ShawnHymel/Matrix_Bow_Tie/Hardware/BOM/Matrix_Bow_Tie.xlsx

Reference | Qty | Value | Footprint | Field4 | Vendor ID | Link | Notes
C1 C5 | 2 | 0.1uF | Capacitors:0603 |  | 490-1532-1-ND | https://www.digikey.com/product-detail/en/murata-electronics-north-america/GRM188R71C104KA01D/490-1532-1-ND/587771
C2 | 1 | 0.01uF | Capacitors:0603 |  | 490-1512-1-ND | https://www.digikey.com/product-detail/en/murata-electronics-north-america/GRM188R71H103KA01D/490-1512-1-ND/587862
C3 | 1 | 10uF | Capacitors:0805 |  | 490-3886-1-ND | https://www.digikey.com/product-detail/en/murata-electronics-north-america/GRM21BR61C106KE15L/490-3886-1-ND/965928
C4 | 1 | 100pF | Capacitors:0603 |  | 490-1427-1-ND | https://www.digikey.com/product-detail/en/murata-electronics-north-america/GRM1885C1H101JA01D/490-1427-1-ND/587633
D1-40 | 40 | Yellow | LED:LED-0603 |  | 732-4981-1-ND | https://www.digikey.com/product-detail/en/wurth-electronics-inc/150060YS75000/732-4981-1-ND/4489907 | Red: 732-4978-1-ND
FB1 FB2 | 2 | BLM18KG221SN1D | Coils:0603 | NDUC-07859 | 490-5255-1-ND | https://www.digikey.com/product-detail/en/murata-electronics-north-america/BLM18KG221SN1D/490-5255-1-ND/1982778
H1 H2 | 2 | STAND-OFF | STAND-OFF
J1 J2 | 2 | CONN_12 | Matrix_Bot_Tie:1X12_SMD_MALE |  | S1033E-12-ND | https://www.digikey.com/product-detail/en/sullins-connector-solutions/GBC12SABN-M30/S1033E-12-ND/862091
MK1 | 1 | MIC-PTH | Silicon-Custom:MICROPHONE-PTH-9.7MM |  | 102-1721-ND | https://www.digikey.com/product-detail/en/cui-inc/CMA-4544PF-W/102-1721-ND/1869981
Q1-4 | 4 | TRANS_NPN_DUAL-MBT3904DW1T1 | Silicon-Standard:SC70-6 |  | MBT3904DW1T1GOSCT-ND | https://www.digikey.com/product-detail/en/on-semiconductor/MBT3904DW1T1G/MBT3904DW1T1GOSCT-ND/918012
R17-21 | 5 | 51 | Resistors:0603 |  | 311-51.0HRCT-ND | https://www.digikey.com/product-detail/en/yageo/RC0603FR-0751RL/311-51.0HRCT-ND/730228
R1 R2 R4 | 3 | 1k | Resistors:0603 |  | 311-1.00KHRCT-ND | https://www.digikey.com/product-detail/en/yageo/RC0603FR-071KL/311-1.00KHRCT-ND/729790
R3 R5 | 2 | 1M | Resistors:0603 |  | 311-1.00MHRCT-ND | https://www.digikey.com/product-detail/en/yageo/RC0603FR-071ML/311-1.00MHRCT-ND/729791
R6 | 1 | 22k | Resistors:0603 |  | 311-22.0KHRCT-ND | https://www.digikey.com/product-detail/en/yageo/RC0603FR-0722KL/311-22.0KHRCT-ND/730003
R7 R8 | 2 | 10K | Resistors:0603 |  | 311-10.0KHRCT-ND | https://www.digikey.com/product-detail/en/yageo/RC0603FR-0710KL/311-10.0KHRCT-ND/729827
R9-16 | 8 | 470 | Resistors:0603 |  | 311-470HRCT-ND | https://www.digikey.com/product-detail/en/yageo/RC0603FR-07470RL/311-470HRCT-ND/730203
S1 | 1 | MOMENTARY-SWITCH-SPST-2-SMD-4.6X2.8MM | Switches:TACTILE_SWITCH_SMD_4.6X2.8MM |  | CKN10246CT-ND | https://www.digikey.com/product-detail/en/c-k/KMR231NG-LFS/CKN10246CT-ND/2176497
U1 | 1 | MAX4466 | Matrix_Bot_Tie:SC70-5 |  | MAX4466EXK+CT-ND | https://www.digikey.com/product-detail/en/maxim-integrated/MAX4466EXK-T/MAX4466EXK-CT-ND/5405773
U2 | 1 | 74HC4051-SOIC16 | Matrix_Bot_Tie:SOIC-16 |  | 296-14530-1-ND | https://www.digikey.com/product-detail/en/texas-instruments/CD74HC4051M96/296-14530-1-ND/555578
VR1 | 1 | 100k | Matrix_Bot_Tie:TC33X |  | TC33X-104ECT-ND | https://www.digikey.com/product-detail/en/bourns-inc/TC33X-2-104E/TC33X-104ECT-ND/612912
