ShawnHymel/Matrix_Bow_Tie/Hardware/bow_tie_outline.dxf

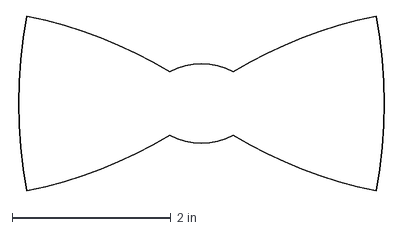
[picture p1: CAD file, 2017-09-09]
Hardware/bow_tie_outline.dxf
4.67 x 2.20 in
