ShawnHymel/Matrix_Bow_Tie/Hardware/Matrix_Bow_Tie.kicad_pcb

## KiCad design Hardware/Matrix_Bow_Tie.kicad_pcb (2017-09-10)

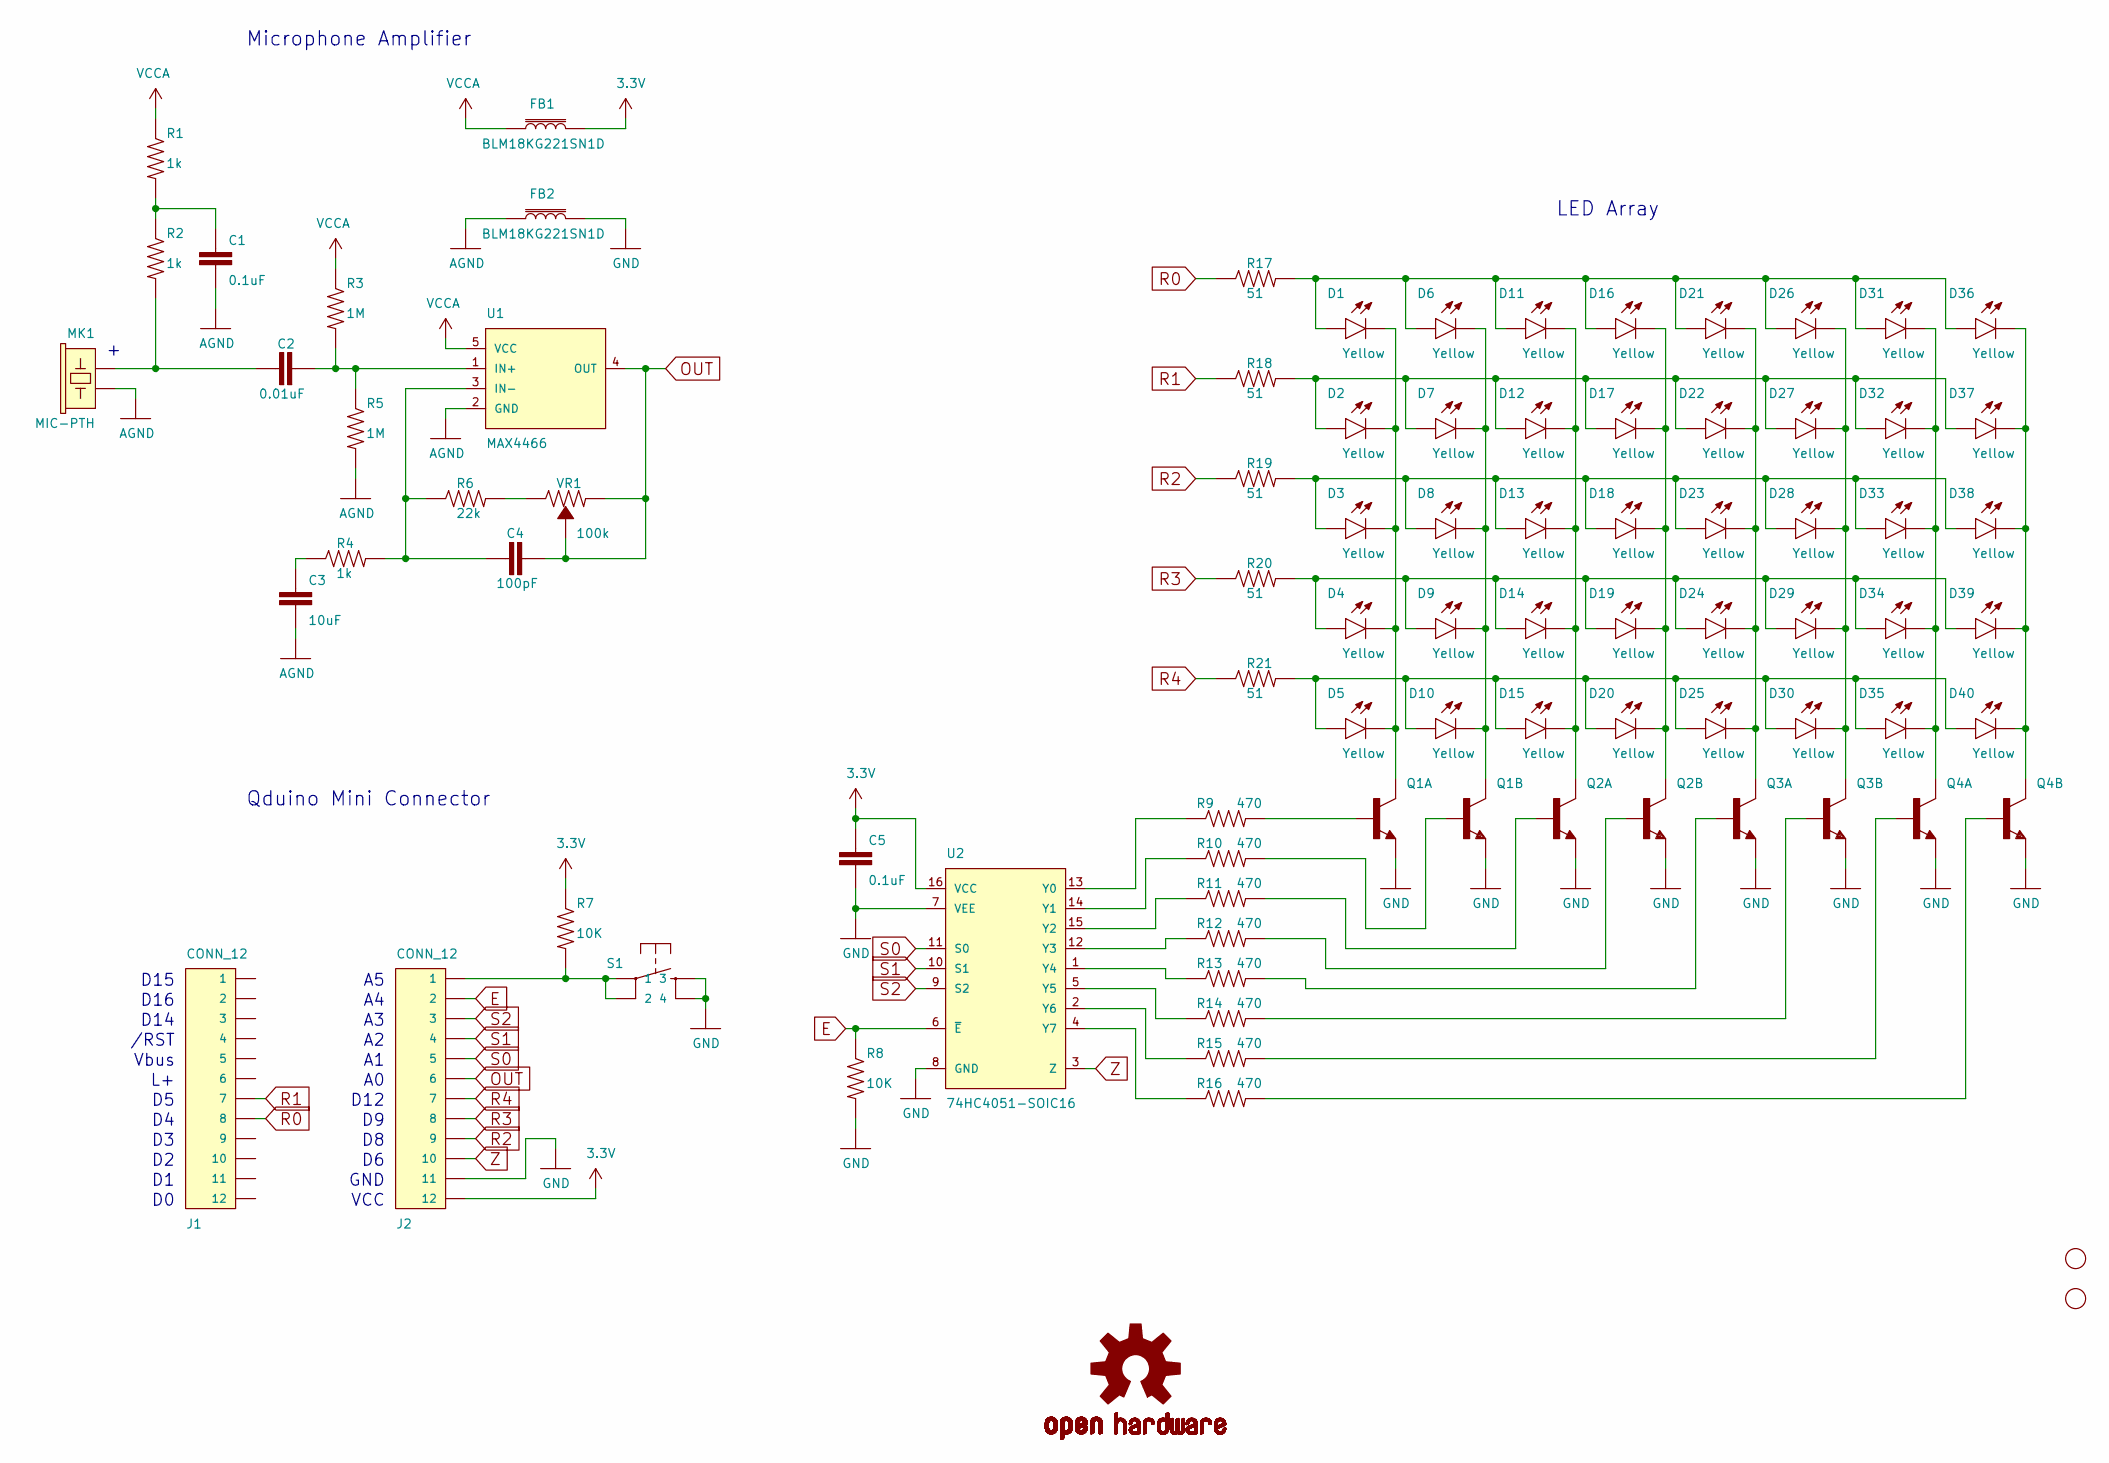
[picture p2: schematic Matrix_Bow_Tie.sch, Matrix Bow Tie]

Parts:
C1, C5: 0.1uF; 0603
C2: 0.01uF; 0603
C3: 10uF; 0805
C4: 100pF; 0603
D1, D2, D3, D4, D5, D6, D7, D8, D9, D10, D11, D12, D13, D14, D15, D16, D17, D18, D19, D20, D21, D22, D23, D24, D25, D26, D27, D28, D29, D30, D31, D32, D33, D34, D35, D36, D37, D38, D39, D40: Yellow; LED-0603
FB1, FB2: BLM18KG221SN1D; 0603
H1, H2: STAND-OFF
J1, J2: CONN_12; 1X12_SMD_MALE
LOGO1: OSHW-LOGOS; OSHW-LOGO-S
MK1: MIC-PTH; MICROPHONE-PTH-9.7MM
Q1, Q2, Q3, Q4: TRANS_NPN_DUAL-MBT3904DW1T1; SC70-6
R1, R2, R4: 1k; 0603
R3, R5: 1M; 0603
R6: 22k; 0603
R7, R8: 10K; 0603
R9, R10, R11, R12, R13, R14, R15, R16: 470; 0603
R17, R18, R19, R20, R21: 51; 0603
S1: MOMENTARY-SWITCH-SPST-2-SMD-4.6X2.8MM; TACTILE_SWITCH_SMD_4.6X2.8MM
U1: MAX4466; SC70-5
U2: 74HC4051-SOIC16; SOIC-16
VR1: 100k; TC33X

Connections:
3.3V: C5.1, FB1.2, J2.12, R7.1, U2.16 (VCC)
AGND: C1.2, C3.2, FB2.1, MK1.GND (2), R5.2, U1.2 (GND)
E: J2.2, R8.1, U2.6 (~E~)
GND: C5.2, FB2.2, J2.11, Q1.1 (E), Q1.4 (E), Q2.1 (E), Q2.4 (E), Q3.1 (E), Q3.4 (E), Q4.1 (E), Q4.4 (E), R8.2, S1.3, S1.4, U2.7 (VEE), U2.8 (GND)
unnamed: C1.1, R1.2, R2.1
unnamed: C2.1, MK1.OUT (1), R2.2
unnamed: C2.2, R3.2, R5.1, U1.1 (IN+)
unnamed: C3.1, R4.1
unnamed: C4.2, R4.2, R6.1, U1.3 (IN-)
unnamed: D1.A, D6.A, D11.A, D16.A, D21.A, D26.A, D31.A, D36.A, R17.2
unnamed: D1.C, D2.C, D3.C, D4.C, D5.C, Q1.3 (C)
unnamed: D5.A, D10.A, D15.A, D20.A, D25.A, D30.A, D35.A, D40.A, R21.2
unnamed: D6.C, D7.C, D8.C, D9.C, D10.C, Q1.6 (C)
unnamed: D11.C, D12.C, D13.C, D14.C, D15.C, Q2.3 (C)
unnamed: D2.A, D7.A, D12.A, D17.A, D22.A, D27.A, D32.A, D37.A, R18.2
unnamed: D3.A, D8.A, D13.A, D18.A, D23.A, D28.A, D33.A, D38.A, R19.2
unnamed: D4.A, D9.A, D14.A, D19.A, D24.A, D29.A, D34.A, D39.A, R20.2
unnamed: D16.C, D17.C, D18.C, D19.C, D20.C, Q2.6 (C)
unnamed: D21.C, D22.C, D23.C, D24.C, D25.C, Q3.3 (C)
unnamed: D26.C, D27.C, D28.C, D29.C, D30.C, Q3.6 (C)
unnamed: D31.C, D32.C, D33.C, D34.C, D35.C, Q4.3 (C)
unnamed: D36.C, D37.C, D38.C, D39.C, D40.C, Q4.6 (C)
unnamed: J2.1, R7.2, S1.1, S1.2
unnamed: Q1.2 (B), R10.2
unnamed: Q1.5 (B), R9.2
unnamed: Q2.2 (B), R12.2
unnamed: Q2.5 (B), R11.2
unnamed: Q3.2 (B), R14.2
unnamed: Q3.5 (B), R13.2
unnamed: Q4.2 (B), R16.2
unnamed: Q4.5 (B), R15.2
unnamed: R6.2, VR1.3 (CW)
unnamed: R9.1, U2.13 (Y0)
unnamed: R10.1, U2.14 (Y1)
unnamed: R11.1, U2.15 (Y2)
unnamed: R12.1, U2.12 (Y3)
unnamed: R13.1, U2.1 (Y4)
unnamed: R14.1, U2.5 (Y5)
unnamed: R15.1, U2.2 (Y6)
unnamed: R16.1, U2.4 (Y7)
OUT: C4.1, J2.6, U1.4 (OUT), VR1.1 (CCW), VR1.2 (WIPER)
R0: J1.8, R17.1
R1: J1.7, R18.1
R2: J2.9, R19.1
R3: J2.8, R20.1
R4: J2.7, R21.1
S0: J2.5, U2.11 (S0)
S1: J2.4, U2.10 (S1)
S2: J2.3, U2.9 (S2)
VCCA: FB1.1, R1.1, R3.1, U1.5 (VCC)
Z: J2.10, U2.3 (Z)

Notes on the sheet:
Microphone Amplifier
D15
D16
D14
/RST
Vbus
D12
GND
VCC
Qduino Mini Connector
LED Array

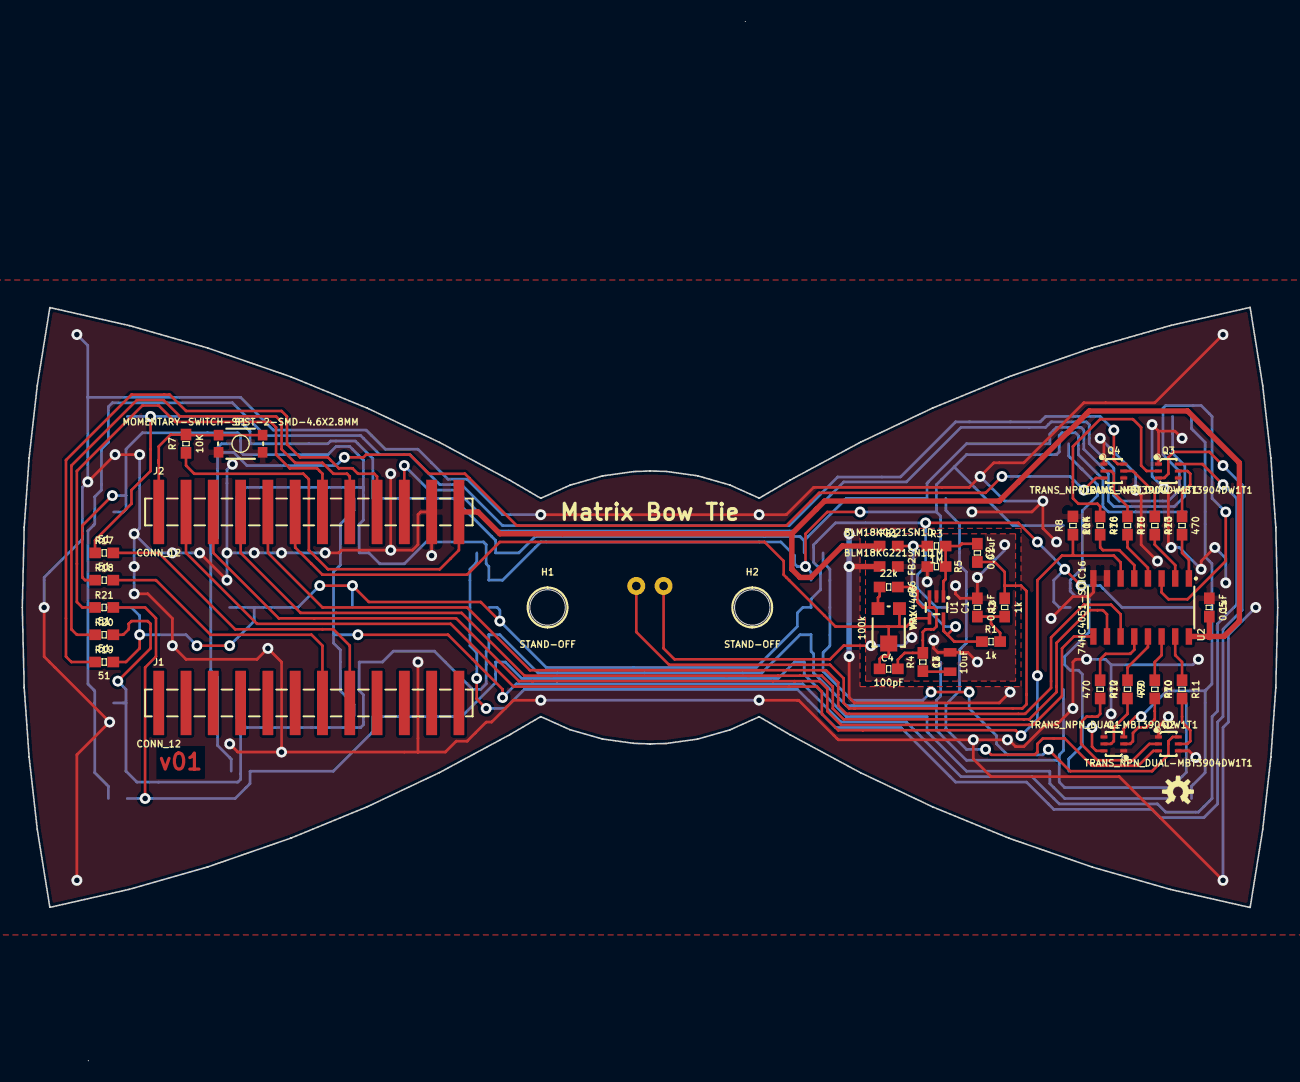
[picture p3: board Matrix_Bow_Tie.kicad_pcb from above]

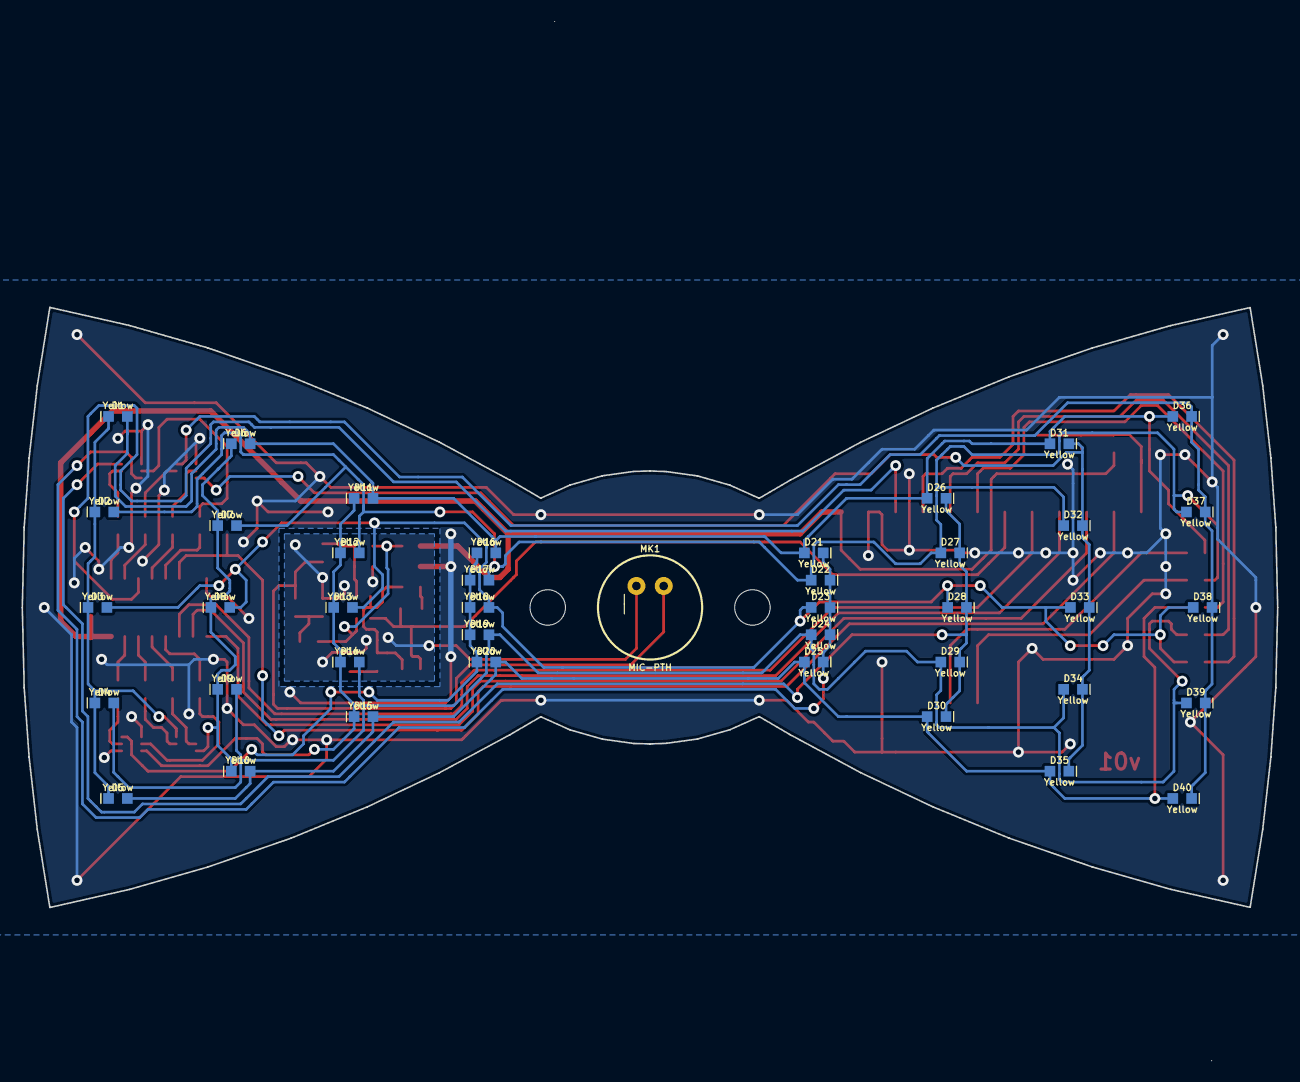
[picture p4: board Matrix_Bow_Tie.kicad_pcb from below]

Board: 2 copper layers, 116.9 x 55.9 mm, 82 parts (41 on the bottom side), 51 nets.
