ShawnHymel/Matrix_Bow_Tie/(commit log)

2017-09-03 Added MAX4466 part and SC70-5 footprint
    [Matrix_Bow_Tie.kicad_pcb, Matrix_Bow_Tie.sch]
2017-09-03 Added trimpot footprint and drew mic amp circuit.
    [Matrix_Bow_Tie.kicad_pcb, Matrix_Bow_Tie.sch]
2017-09-09 Parts mostly laid out
    [Matrix_Bow_Tie.kicad_pcb, Matrix_Bow_Tie.sch, bow_tie_outline.dxf]
2017-09-09 Added BOM
    [Matrix_Bow_Tie.csv, Matrix_Bow_Tie.kicad_pcb, Matrix_Bow_Tie.xlsx]
2017-09-09 More progress on layout
    [Matrix_Bow_Tie.kicad_pcb, Matrix_Bow_Tie.sch]
2017-09-10 Layout complete. Gerbers ran.
    [Matrix_Bow_Tie-B.Cu.gbl, Matrix_Bow_Tie-B.Mask.gbs, Matrix_Bow_Tie-B.SilkS.gbo, Matrix_Bow_Tie-Edge.Cuts.gm1, Matrix_Bow_Tie-F.Cu.gtl, Matrix_Bow_Tie-F.Mask.gts, Matrix_Bow_Tie-F.SilkS.gto, Matrix_Bow_Tie.drl]
2017-09-10 Re-did copper pour. Magic happened. It fits the outline better now.
    [Matrix_Bow_Tie-B.Cu.gbl, Matrix_Bow_Tie-B.Mask.gbs, Matrix_Bow_Tie-B.SilkS.gbo, Matrix_Bow_Tie-Edge.Cuts.gm1, Matrix_Bow_Tie-F.Cu.gtl, Matrix_Bow_Tie-F.Mask.gts, Matrix_Bow_Tie-F.SilkS.gto, Matrix_Bow_Tie.drl]
