ShawnHymel/Matrix_Bow_Tie/(notices)

Notices in the files:
Hardware/Matrix_Bow_Tie.sch:
https://creativecommons.org/licenses/by-sa/4.0
Creative Commons Attribution Share-Alike 4.0 License
